fraciscoestar/finger-vascular-biometry/cad/3d/prototipo TFG - main.stl

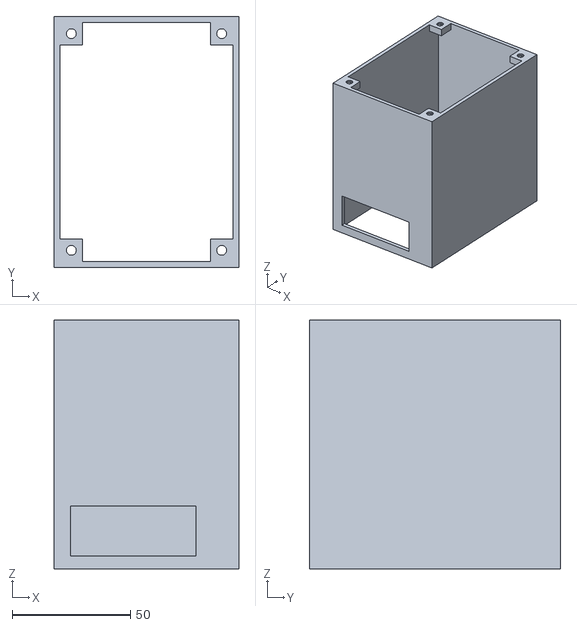
[picture p42: CAD file, 2024-10-17]
cad/3d/prototipo TFG - main.stl
78.0 x 106.0 x 105.0
