fraciscoestar/finger-vascular-biometry/cad/3d/pcb.stl

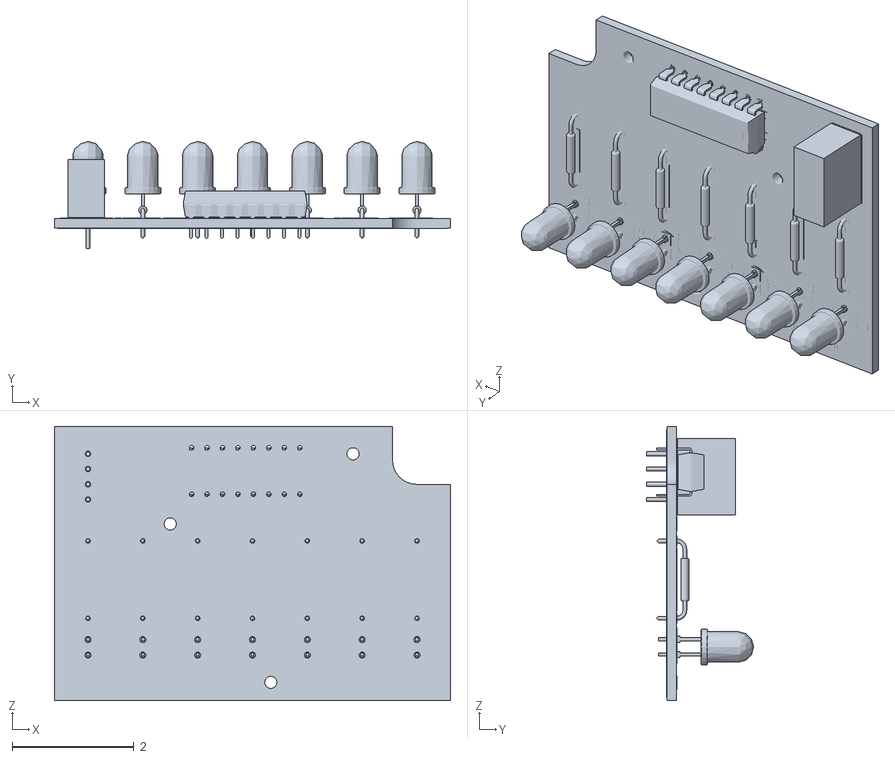
[picture p43: CAD file, 2024-10-17]
cad/3d/pcb.stl
6.50 x 1.76 x 4.50
