fraciscoestar/finger-vascular-biometry/cad/3d/prototipo TFG - leds.stl

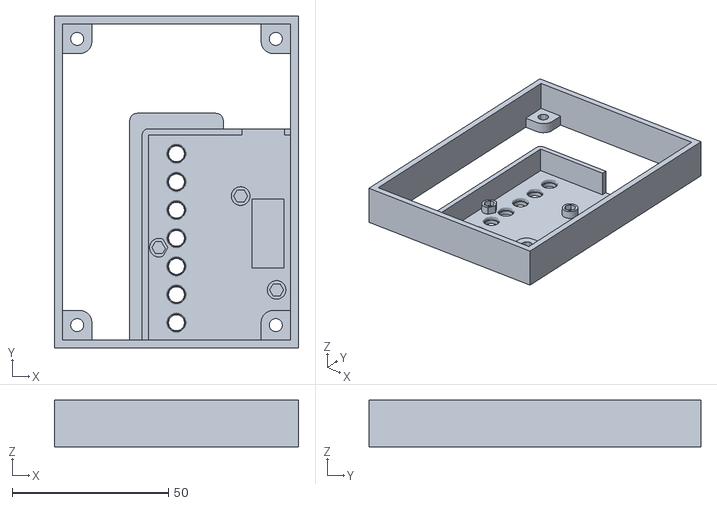
[picture p44: CAD file, 2024-10-17]
cad/3d/prototipo TFG - leds.stl
78.0 x 106.0 x 15.0
