fraciscoestar/finger-vascular-biometry/cad/3d/prototipo TFG - cover.stl

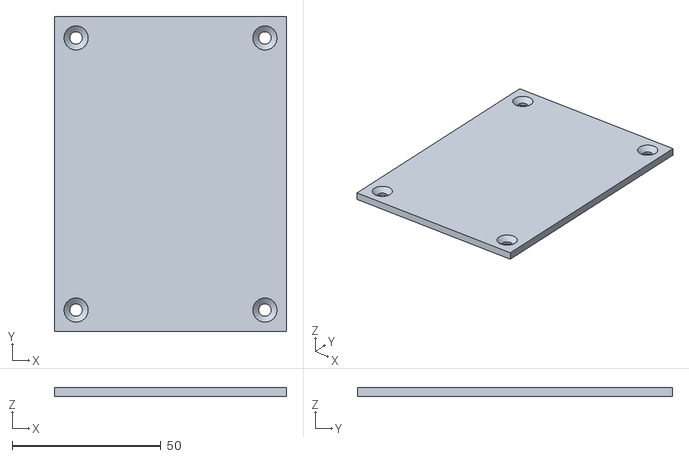
[picture p45: CAD file, 2024-10-17]
cad/3d/prototipo TFG - cover.stl
78.0 x 106.0 x 3.00
