fraciscoestar/finger-vascular-biometry/cad/3d/prototipo TFG - finger.stl

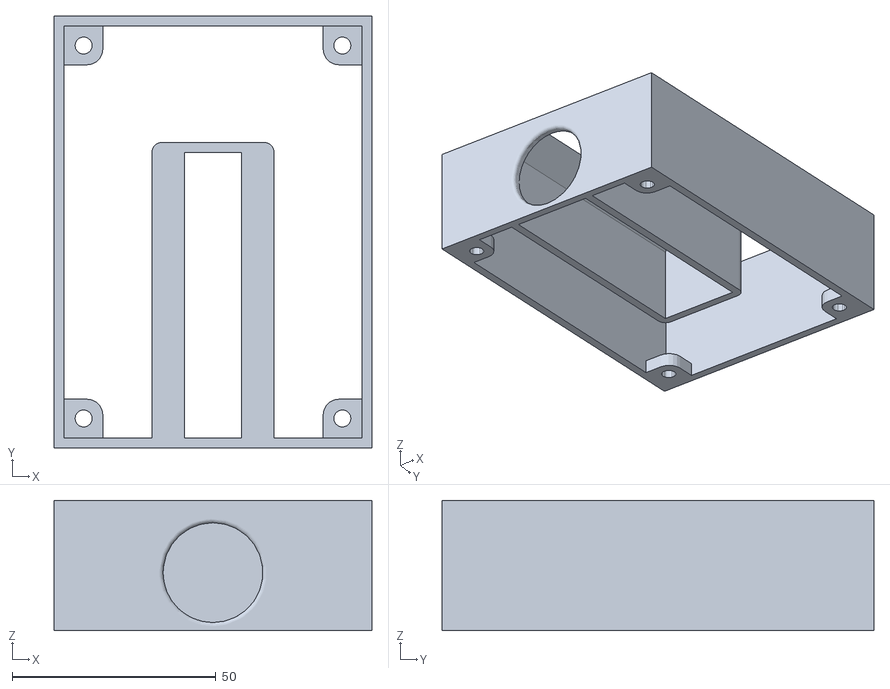
[picture p46: CAD file, 2024-10-17]
cad/3d/prototipo TFG - finger.stl
78.0 x 106.0 x 32.0
