fraciscoestar/finger-vascular-biometry/cad/3d/prototipo TFG - bottom cover.stl

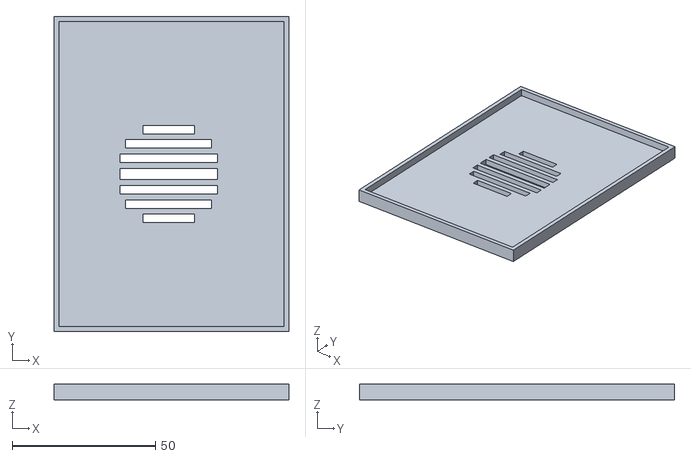
[picture p47: CAD file, 2024-10-17]
cad/3d/prototipo TFG - bottom cover.stl
82.0 x 110.0 x 5.50
