fraciscoestar/finger-vascular-biometry/cad/pcb/layout.pdf

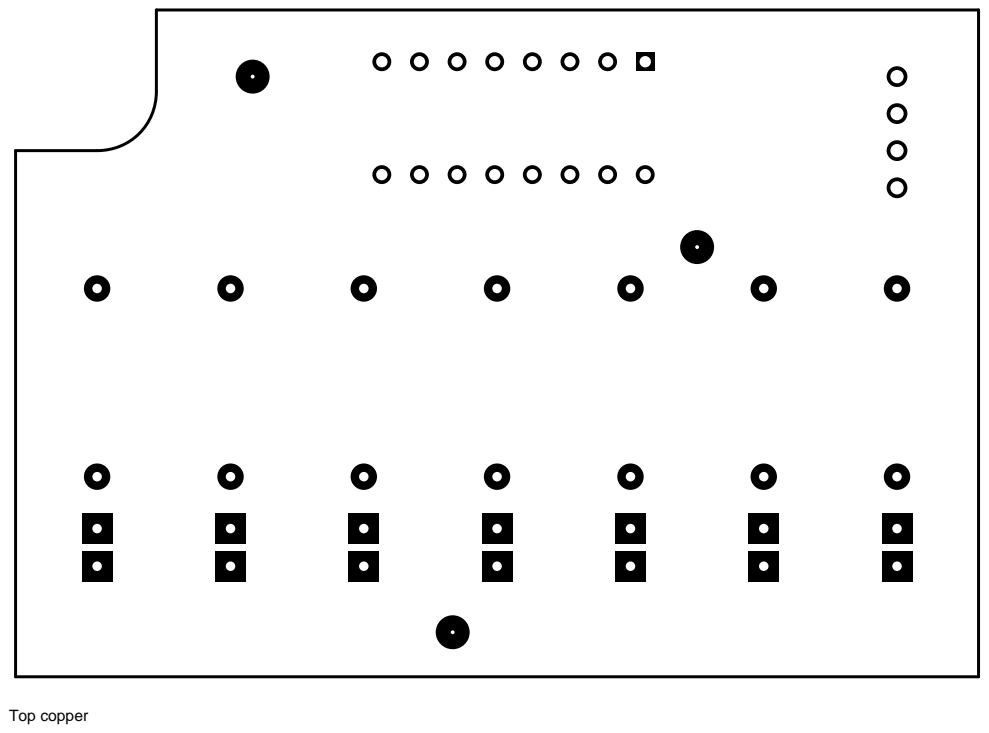
[picture p48: page 1]
Top copper

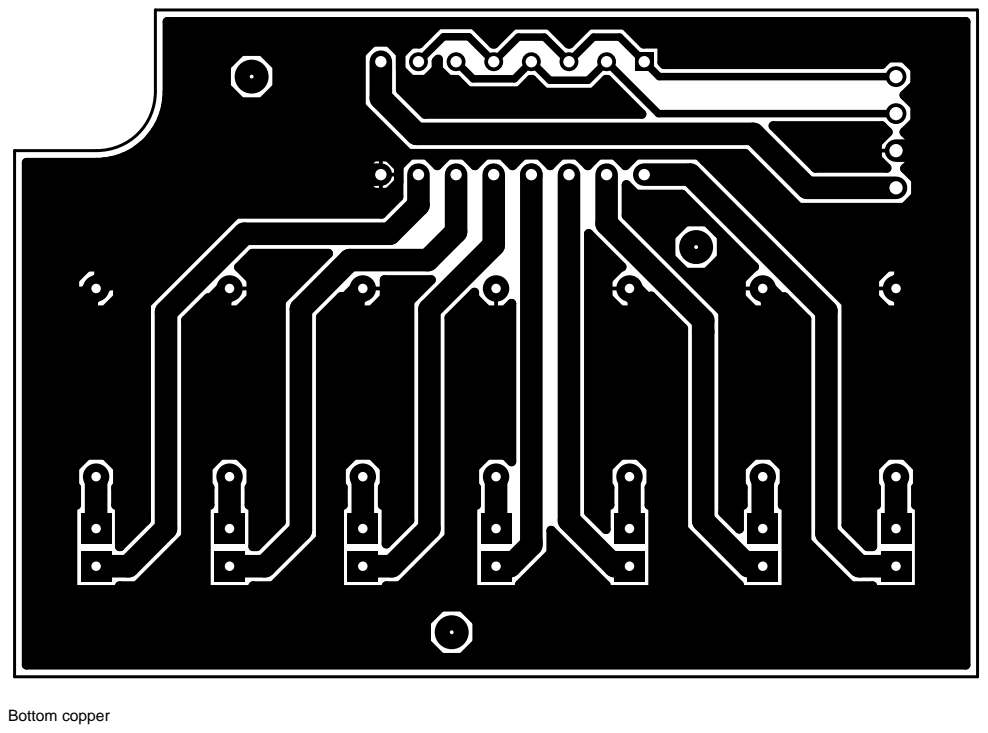
[picture p49: page 2]
Bottom copper

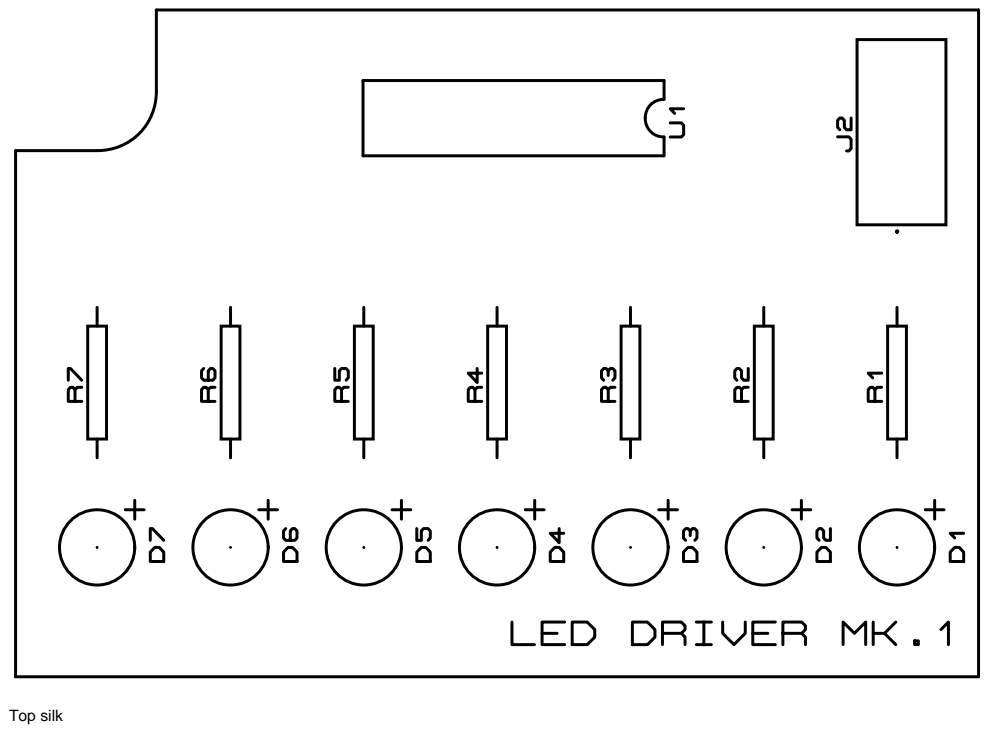
[picture p50: page 3]
Top silk

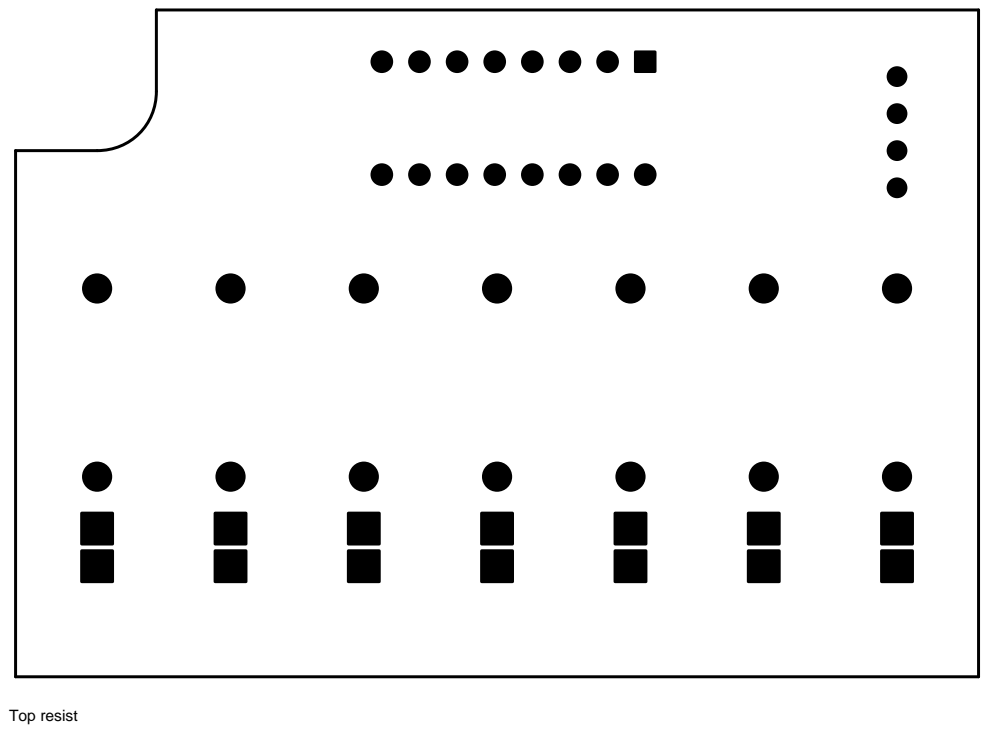
[picture p51: page 4]
Top resist

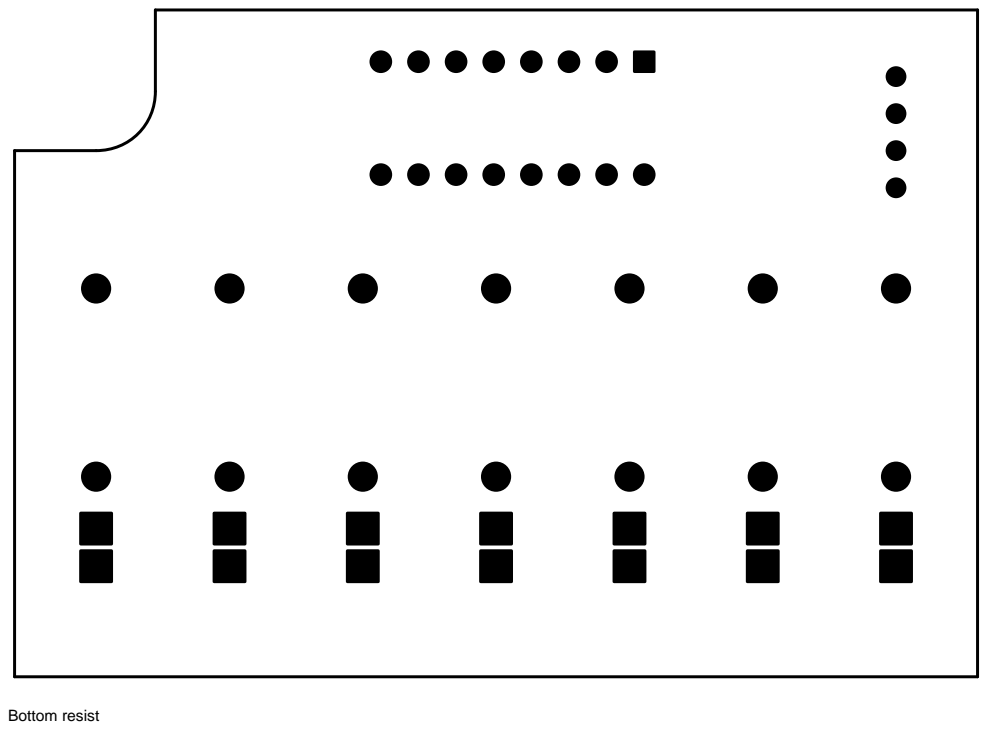
[picture p52: page 5]
Bottom resist

Board edge
