fraciscoestar/finger-vascular-biometry/cad/pcb/schematic.pdf

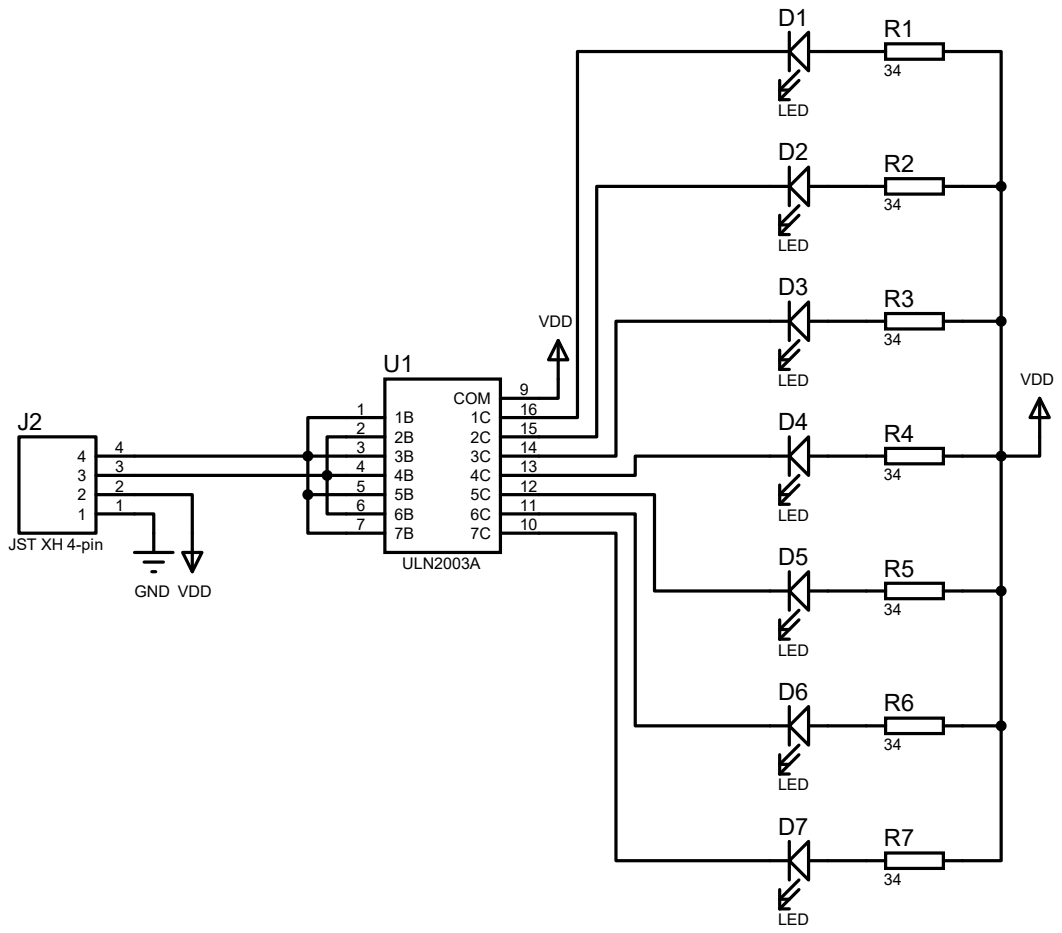
[picture p53: page 1]
